carlosmsx/MSX-SDF-1/hardware/rev1/sdf1-sch.pdf

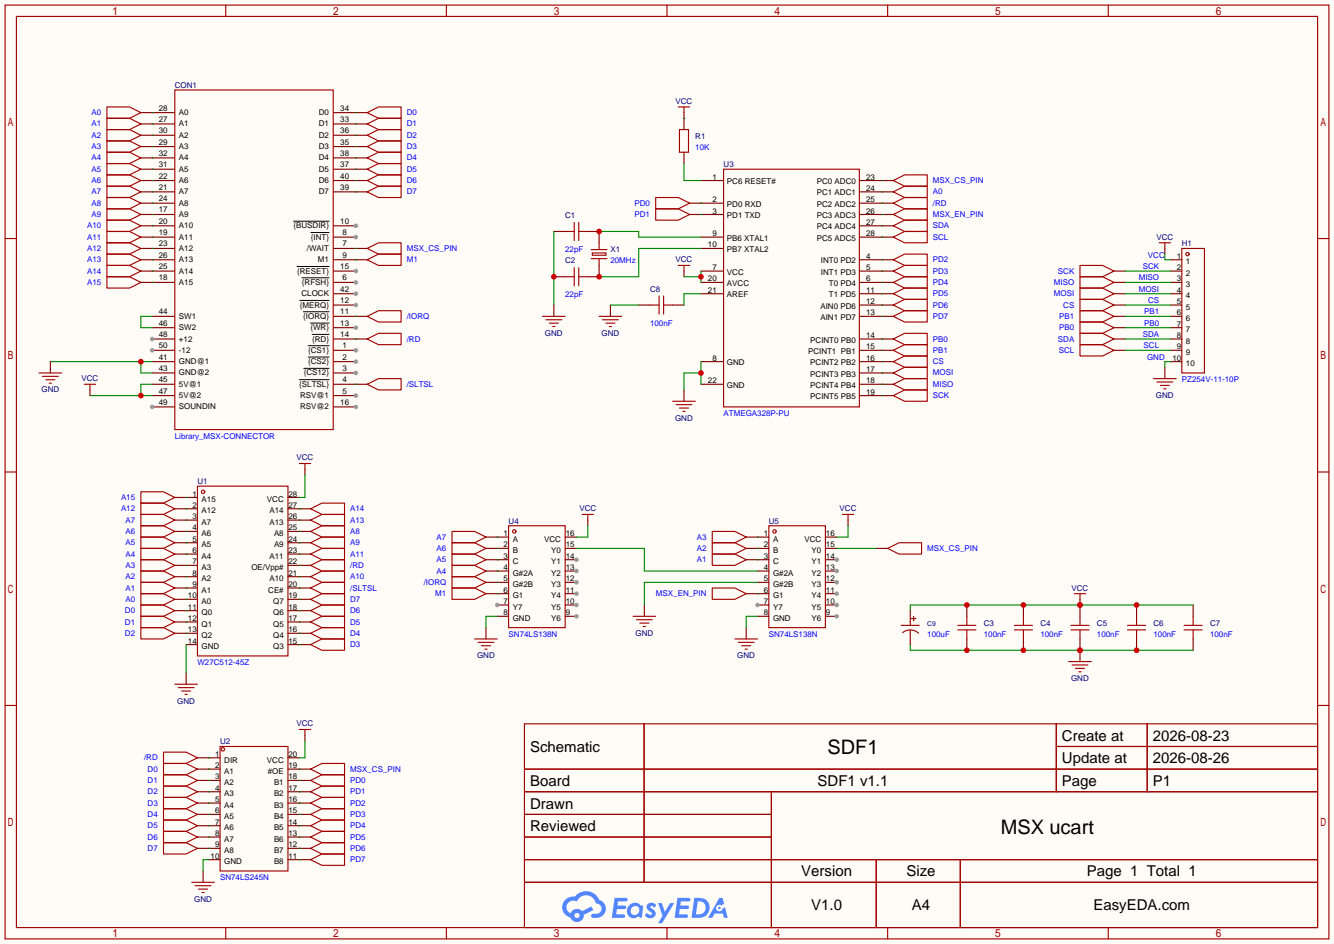
[picture p1: page 1]

Schematic | SDF1 | Create at | 2026-08-23

Update at | 2026-08-26

Board | SDF1 v1.1 | Page | P1
Drawn | | MSX ucart
Reviewed

Version | Size | Page 1 Total 1
V1.0 | A4 | EasyEDA.com
