carlosmsx/MSX-SDF-1/(commit log)

2023-04-13 Update README.md
    Agregando un poco mas de descripcion sobre el proyecto
2023-04-13 agregado codigo fuente para el atmega328p
2026-08-29 primer prototipo de PCB
    [sdf1-bom.csv]
2026-09-02 README: presentar la placa como kit de desarrollo
    El SDF-1 pasa a describirse como un kit de desarrollo para MSX -- una placa
    de I/O universal y experimental -- y el lector de memorias SD como su primer
    proyecto de ejemplo, que es lo unico terminado hoy.
    - Nueva seccion "La placa como kit": el hardware no es especifico de leer
    disquetes, el area de islas perforadas es parte del diseno, y el pinout de
    H1 (sin serigrafiar en la rev1) para colgar hardware propio del I2C/SPI
    - Advertencia explicita de que puerto serie, sensores y puente WiFi son
    intencion de diseno y todavia no existen como firmware ni ROM
2026-09-03 README: acreditar el Virtual MSX Disk Drive como antecedente
    El proyecto parte de la idea que Raul publico en codinglab en 2013:
    decodificar un puerto de I/O, bajar el /WAIT del Z80 con esa misma
    senal, y contestar con un microcontrolador mientras la maquina espera.
    La seccion nueva da el credito y detalla los siete puntos en los que
    este diseno se aparta del original: lee la SD sin PC de por medio,
    decodifica A7..A1 en vez de una ventana de puertos, separa datos de
    comando/estado en dos registros, documenta las cuatro lineas de
    control que van al micro, maneja el /WAIT con una compuerta de
    colector abierto, corre el ATmega a 20 MHz, y publica el codigo.
2026-09-03 README: bajar el peso del antecedente, subir el de las mejoras
    La seccion daba dos parrafos al proyecto original y cerraba diciendo
    que sin el no existiria. La idea es al reves: mencionar de donde sale
    la tecnica del /WAIT y que el foco quede en como esta resuelto todo lo
    demas. El credito pasa a una oracion con el link inline, y la seccion
    se llama ahora "Las decisiones de diseño".
2026-09-12 firmware y DiskROM: comandos CALL SDF y montaje de DSK desde la SD
    CALL SDFFILES lista los .DSK de la raiz, CALL SDFMOUNT(drive,"archivo") monta una imagen en A o B y CALL SDFUMOUNT(drive) la desmonta. El montaje se guarda en la EEPROM y ya no hay DSK fijos por defecto. CALL SDFTEST muestra la version del firmware y compara el protocolo con la ROM.
    DSKCHG consulta al firmware (portado de ZiggyBox, con flag por drive y DPB actualizado) y READ/WRITE leen un byte de estado antes de los sectores: un drive vacio devuelve not ready en vez de basura. Los codigos de comando quedan agrupados por funcion (0xDx diagnostico, 0xEx SD, 0xFx driver). Se corrige CHKCHAR, que caia en TYPE_MISMATCH. Protocol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
    [defs.h, sdf-1-atmega328p.ino]
2026-09-12 Makefile: make flash graba el .hex directo con avrdude
    arduino-cli upload con programador busca el .with_bootloader.hex, que MiniCore borra con bootloader=no_bootloader, asi que make flash fallaba siempre. Ahora llama a avrdude con el .ino.hex, elige -p m328p o m328 segun la variante del FQBN, y make check verifica avrdude y su avrdude.conf.
2026-09-12 hardware/rev1: correcciones en vez de bodges, mapas de cortes y de senales
    BODGES.md pasa a CORRECCIONES.md, sin la firma AB ni el cristal (el error del BOM queda en el README de rev1 y va a la rev2). /WAIT sale por dos compuertas de U6 (74LS03); /BUSDIR queda para mas adelante y /RESET del MSX a PB0 queda a probar.
    cortes-rev1.svg ubica los dos cortes y los puntos de soldadura sobre las pistas reales, sacadas de los Gerbers. senales-rev1.svg muestra que senal del bus del MSX llega a cada pad, para usar la placa sin los integrados.
2026-09-12 firmware: publicar el .hex con los comandos CALL SDF (version 0.1, protocolo 1)
    Compilado desde el codigo de este branch; verificado byte a byte contra una recompilacion y contra lo grabado en el ATmega328P. Va con una DiskROM compilada desde el mismo codigo: el protocolo cambio.
2026-09-12 tools: scripts de los mapas del PCB, make mapas y make icsp
    placa.py lee los derivados de una revision (Gerbers, FlyingProbeTesting.json, drills y netlist) y arma el grafo del cobre. mapa_cortes.py dibuja cortes-rev1.svg y con --analizar repite el estudio que eligio los cortes; mapa_senales.py dibuja senales-rev1.svg. make mapas los regenera.
    make icsp comprueba la conexion ICSP con el ATmega sin escribir nada: lee firma, fuses y lock, y con ICSP_EXTRA puede verificar la flash.
2026-09-12 hardware/rev1: mapas regenerados con los dos agujeros de fijacion del conector
    Los dos agujeros de fijacion del conector de cartucho se llaman igual en el archivo de test (CON1_999) y los scripts originales guardaban uno solo. En senales-rev1.svg ademas salia como un contacto cuadrado; ahora son dos circulos. El resto de los dos SVG no cambia.
2026-09-12 Makefile: anda desde PowerShell y cmd, sin sh
    Sin sh en el PATH, make corre las recetas con cmd.exe y fallaba: las carpetas del Arduino IDE se calculaban con $(shell cygpath) y quedaban vacias, asi que make icsp y make flash armaban el comando de avrdude sin ruta.
    Ahora las carpetas salen de USERPROFILE y LOCALAPPDATA leidas por make, arduino-cli recibe sus variables con export, los chequeos de make check usan wildcard/error/info, crear y borrar out/ va con python, y la receta de LK80 queda en una sola linea. Probado desde PowerShell y Git Bash: check, clean, rom, firmware, icsp y flash.
2026-09-12 hardware/rev1: U6 usa las compuertas 3 y 4 del 74LS03
    La 4 (12, 13 -> 11) hace de inversor y la 3 (9, 10 -> 8) de /WAIT: quedan todas del mismo lado del integrado, junto al pin 14 de VCC, y el puente del 11 al 10 es entre pines vecinos. Las compuertas 1 y 2 quedan libres para /BUSDIR. Actualizados la tabla, el pull-up, el checklist y la leyenda de cortes-rev1.svg.
2026-09-14 README: el kit lleva una EEPROM de 64 K regrabable, no una ROM de 16 K
    Los 16 K son de la DiskROM del lector de SD; la W27C512 se ve completa en el slot y se regraba con un adaptador.
2026-09-14 diskrom y firmware: imagenes DSK de 360 KB
    GETDPB elige el DPB por el primer byte de la FAT: F8 es un 360 KB de una
    cara, cualquier otro valor sigue siendo 720 KB. El kernel de DOS1 lee la FAT
    despues de un DSKCHG con cambio y llama a GETDPB con ese byte, asi que la ROM
    solo agrega la tabla y la eleccion. DEFDPB queda en el de 720 KB.
    El firmware acepta imagenes de 368640 bytes ademas de las de 737280, sin
    mirar el byte de la FAT: las imagenes de juegos sin FAT siguen montando. Una
    escritura con el DPB de 720 KB sobre una imagen que no es de 720 se rechaza
    con write fault, para que una ROM vieja no corrompa un 360 KB.
    Protocolo 2: la ROM y el firmware se graban juntos.
2026-09-15 firmware: arranca sin SD y SDFTEST muestra el estado de la SD
    setup() ya no espera a que la SD ande: la inicializa loop(), reintentando
    cada 250 ms, y mientras tanto la ISR atiende al MSX. Los comandos que
    necesitan la SD contestan que no esta (Disk offline, not ready, lista vacia)
    y CALL SDFTEST muestra por que: ok, iniciando, no contesta, no es FAT o el
    codigo de error de SdFat. Version 0.2.
    Makefile: los datos de BASDATA vuelven a F327h. El .REL de N80 le hacia
    reservar a LK80 un byte de datos de mas y corria las variables de sistema de
    MSX-DOS; con --data F327h antes de BASDATA el link reproduce la ROM de
    ZiggyBox byte a byte. Las rutas de out/ en python van como cadenas crudas.
    [defs.h, sdf-1-atmega328p.ino]
2026-09-15 diskrom y firmware: pagina 2 con CALL SDFNEW y formateo de imagenes
    La EEPROM usa la pagina 2 (8000h) para las rutinas de manejo, en
    diskrom/PAGE2.MAC: un binario absoluto aparte, sin codigo del kit de ASCII,
    que mkrom.py agrega a la imagen. La pagina 1 solo lee argumentos de BASIC y
    salta con CALLP2 (GETSLOT y ENASLT, y RAMAD2 al volver). SDFMOUNT y
    SDFUMOUNT quedan en la pagina 1; SDFFILES y SDFTEST se mudaron enteros. Los
    codigos de comando pasan a diskrom/PROTOCOL.INC, y sale codigo muerto de la
    pagina 1: le quedan 2057 bytes libres.
    CALL SDFNEW("archivo"[,360|720]) crea una imagen formateada y llena de
    ceros, sin montarla. CALL FORMAT y el FORMAT de MSX-DOS formatean la imagen
    montada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
2026-09-21 tools/mkrom.py: escribe la entrada DEVICE de la cabecera
    DOSHEAD trae 4006h en 0 y el BIOS arma SLTATR al arrancar, asi que el
    cartucho no puede prenderse el bit de DEVICE desde su INIT: tiene que venir
    en la imagen. LK80 deja la lista de simbolos en out/msxdos.sym y mkrom.py
    escribe ahi la direccion de OEMDEV, si existe. Falla si el simbolo cae fuera
    de la pagina 1 o si 4006h no venia en 0.
2026-09-21 diskrom y firmware: dispositivos de BASIC, RTC: sobre un DS1307 y CALL SDFDEBUG
    La ROM gana OEMDEV, un tubo generico sin tabla de nombres: le pregunta al
    firmware si un nombre es suyo (comandos 0x9x) y despues mueve bytes. Un
    dispositivo nuevo es firmware, no ROM. El despachador preserva DE: el OPEN
    lee el modo en E y el codigo en D.
    El primer dispositivo es RTC:, sobre un DS1307 por I2C. LINE INPUT trae la
    hora de ese momento, con formatos RTC:, RTC:D, RTC:T, RTC:N y RTC:W; PRINT #
    pone el reloj y EOF avisa si la hora no es confiable. El I2C va con el TWI
    en crudo, sin Wire (182 bytes de RAM menos), y nunca desde la ISR: loop()
    relee el chip a una copia doble y la ISR arma la linea desde a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
2026-09-21 pruebas: sketches de prueba de perifericos con un Nano
    Enlace I2C con un ESP32 (maestro Nano, esclavo ESP32) y un MAX7219.
2026-09-22 Makefile y parche para DS1307: redirigir B4h/B5h a puertos del firmware
    Agrega 'make rom-rtc' que compila la DiskROM y parchea los 27 accesos
    a los puertos RP-5C01 (B4h/B5h) para redirigirlos a los puertos 0/1
    del firmware, donde se emula el RP-5C01 completo usando un DS1307 por I2C.
    Cambios:
    - Makefile: nueva regla 'rom-rtc' que aplica el parche automáticamente
    - tools/patch_rtc.py: parche que reemplaza inmediatos de puerto
    * OUT (0B4h),A → OUT (0x01),A (comando)
    * OUT (0B5h),A → OUT (0x00),A (datos escritura)
    * IN A,(0B5h) → IN A,(0x00) (datos lectura)
    Verificado: los 27 accesos encontrados y parcheados en el rango 0x40BA-0x41BA.
    El espacio en ROM no cambia (solo r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
2026-09-22 Firmware: emulación del RP-5C01 en puertos 0/1 usando DS1307
    Implementa la emulación completa del RP-5C01 (reloj de MSX2) usando el DS1307
    por I2C. La DiskROM accede a los puertos redirigidos (0x00/0x01) que el firmware
    atiende, pensando que está hablando con un RP-5C01 real.
    Cambios en el firmware:
    - Shadow de 52 bytes para los 4 bancos (0=reloj, 1=alarma, 2/3=RAM CMOS)
    - Manejador de comandos 0x0X: latchea el registro seleccionado
    - Lectura de nibbles: devuelve 0F0h | nibble como el chip real
    - Escritura de nibbles: actualiza el shadow, marca para escribir al DS1307
    - rtcUpdateShadow(): convierte DS1307 (BCD 8-bit) al formato RP-5C01 (nibbles)
    - Llamado desde loop() cada 25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
2026-09-22 Tools: verificación de parche DS1307 en ROM
    Agrega dos scripts para verificar que la ROM grabada tiene el parche DS1307:
    1. verify_rtc.py: verifica que el parche esté correctamente aplicado
    - Busca los 27 patrones parchados (D301, D300, DB00)
    - Verifica que NO haya patrones antiguos (D3B4, D3B5, DBB5)
    - Cuenta y reporta coincidencias esperadas
    - Salida clara: ✓ ROM VERIFICADA o ✗ ROM NO VERIFICADA
    2. fingerprint_rtc.py: genera un fingerprint para guardar junto a la ROM
    - Extrae bytes clave de 6 ubicaciones (primero y último de cada patrón)
    - Calcula SHA256 y MD5 de esos bytes
    - Genera archivo .fingerprint con la información
    - Útil para comparar luego si es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
2026-09-22 Firmware: corrige la decodificacion de banco/registro del RP-5C01 emulado
    Bug encontrado al probar en hardware: el MSX seguia pidiendo fecha al
    arrancar pese a que la ROM tenia el parche aplicado. La emulacion del
    RP-5C01 tenia dos errores de diseño:
    1. Decodificacion de banco/registro incorrecta. El indice de registro
    (0-Fh) que llega por el puerto de comando NO codifica el banco: el
    banco activo lo fija el VALOR que se escribe en el registro de modo
    (indice 0Dh), en sus bits 0-1. El codigo anterior extraia "banco" y
    "registro" de los bits del indice mismo, que es un modelo distinto
    e incorrecto del chip. Con eso, cuando CHKCLK seleccionaba banco 2
    (RAM CMOS) para la pru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
    [sdf-1-atmega328p.ino]
2026-09-22 Reloj: camino A - parchear CHKCLK/$GETTI/$SETDA/$SETTI en vez de emular el RP-5C01
    El camino B (emular el RP-5C01 completo en los puertos B4h/B5h, commits
    5570ffa/12786b7/6f55042) se probo en hardware y sigue pidiendo fecha al
    arrancar. Diagnostico: no es un bug de logica sino un limite de timing.
    El bucle de deteccion de CHKCLK hace un OUT seguido de un IN con solo 8
    T-states de separacion (~2,2us a 3,58MHz) - el acceso mas apretado de toda
    la ROM, ya señalado como riesgo en reloj-cuatro-caminos.md. El firmware
    tarda 6us (MSX_REENABLE_DELAY_US, documentado y deliberado en defs.h) en
    rehabilitar el decoder entre accesos, asi que ese segundo acceso cae dentro
    de la "cuarentena": el decoder n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
    [defs.h, sdf-1-atmega328p.ino]
2026-09-23 firmware: publicar el .hex 0.2 (protocolo 6)
    Compilado con make -B firmware desde ea9960c: 22656 bytes de flash (69 %),
    710 de RAM libres. Suma el reloj DS1307 (OPEN "RTC:", CALL RTC y el camino A
    para MSX-DOS), CALL SDFNEW, imagenes de 360 KB y CALL SDFDEBUG.
    El README aclara que va con una ROM del mismo commit y que la fecha en
    MSX-DOS pide make rom-rtc.
2026-09-23 README: el reloj DS1307 como segundo proyecto de ejemplo
    El README decia que el lector de SD era lo unico terminado. Ahora nombra
    el reloj, con links a las paginas de los dos ejemplos en dpc200.com.ar.
2026-09-24 README: tono mas formal, y el proyecto de Raul como inspiracion
    El texto pasa a un registro formal e impersonal, sin voseo ni
    expresiones coloquiales. El contenido tecnico no cambia.
    La seccion de decisiones de diseño ya no compara punto por punto con
    el Virtual MSX Disk Drive: dice que el proyecto esta inspirado en el,
    del que toma la tecnica del /WAIT, y describe los agregados y mejoras
    por si mismos.
2026-09-24 Firmware: /WAIT diferido, y el SD.open de DSKIO pasa a loop()
    Primer paso para sacar la SD de la ISR. Cuando un acceso necesita la SD,
    la ISR vuelve sin soltar /WAIT y deja el pedido en _deferred; loop() hace
    el trabajo con las interrupciones habilitadas, pone el byte en el bus y
    suelta /WAIT (serviceDeferred/replyDeferred). El MSX ve lo mismo que antes:
    la ROM y el protocolo no cambian.
    El primer uso es abrir la imagen de DSKIO: el SD.open() y el seek() salen
    de processData() y los hace loop() cuando el MSX lee el byte de estado.
    Los rechazos que no necesitan la SD (sin tarjeta, drive sin imagen) siguen
    contestandose desde la ISR, sin diferir.
    El EEPROM.update de loop() atiende pedidos en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
2026-09-24 Pruebas: SDFBENCH.BAS, velocidad del disco desde Disk BASIC
    Escritura y lectura de 16 KB x 8 con BSAVE/BLOAD, verificacion contra la
    BIOS y 64 GET al azar. Cada corrida se agrega a RESULT.TXT con una
    etiqueta, para comparar versiones sobre la misma imagen. Los .BAS se fijan
    en CRLF, que es lo que espera el LOAD del MSX.
2026-09-24 SDFBENCH: medir con RTC: en lugar de TIME
    TIME no cuenta mientras se accede al disco (interrupciones cortadas): la
    primera corrida dio 156 KB/s de lectura, mas de tres veces el maximo
    posible. Cada prueba arranca en un cambio de segundo del reloj y al final
    descuenta, con TIME, la espera hasta el segundo siguiente, que no toca el
    disco. Pruebas mas largas (N=32, M=256) para que el error de +-0,25 s del
    reloj quede en ~1 %. Sin reloj vuelve a TIME y lo marca en RESULT.TXT.
2026-09-25 SDFBENCH: reponer HIMEM al terminar
    El CLEAR 300,&H9800 deja la pila en la pagina 2, y CALLP2 cambia esa
    pagina a la ROM: CALL SDFTEST, SDFFILES, SDFNEW y el formateo se cuelgan
    hasta resetear. El HIMEM original se guarda en D81E-D81F antes del CLEAR
    y se repone en todas las salidas.
2026-09-26 SDFBENCH: dia de semana como texto, y reponer HIMEM tambien tras un error
    INPUT # del ultimo campo de RTC:N da Type mismatch con una variable
    numerica; con W$ anda. El manejador de errores hacia ON ERROR GOTO 0, que
    corta el programa en el acto y salteaba la linea 950: ahora sale con
    RESUME 950, que repone HIMEM.
2026-09-26 Firmware: version desde git, y fecha y hora de compilacion en SDFDEBUG
    make firmware pasa FW_GIT con git describe: CALL SDFTEST muestra
    "0.2-8-abc1234" (tag, commits desde el tag, commit) y un * si se compilo
    con cambios sin commitear. Desde el IDE, sin git, queda la version a mano
    con la fecha, como antes. El firmware se compila siempre (FORCE), porque
    la version cambia con cada commit aunque las fuentes no.
    Al arrancar deja en el buffer de CALL SDFDEBUG la version con la fecha y
    hora exactas de compilacion. El texto va en la flash (dbgP/PSTR): la RAM
    baja de 1338 a 1318 bytes.
2026-09-26 Firmware: estadisticas del disco en CALL SDFDEBUG
    Para medir antes de optimizar. Con DSK_STATS, el firmware cuenta las
    llamadas a DSKIO y los sectores, y mide con Timer1 (3,2 us por tick) el
    tiempo de abrir la imagen, de dsk.read() (separando las lecturas que traen
    un bloque de la SD), dsk.write(), flush() y close(). CALL SDFDEBUG agrega
    el informe al buffer y pone todo en cero; lo arma loop() por /WAIT
    diferido, porque son divisiones de 32 bits.
    Cuesta ~35 ciclos por byte en la ISR, 84 bytes de RAM (buffer de
    SDFDEBUG a 128) y 1,6 KB de flash; DSK_STATS 0 lo saca del todo.
    SDFBENCH llama a CALL SDFDEBUG despues de cada prueba.
2026-09-26 Firmware: las imagenes de A y B quedan abiertas entre un DSKIO y otro
    Abrir la imagen buscaba el nombre en la raiz de la SD en cada llamada a
    DSKIO: ~19 ms, medido con las estadisticas de SDFDEBUG (29 % del tiempo de
    un GET al azar). Ahora dskioOpen() la abre la primera vez que hace falta y
    la deja abierta en _img[drive]; cada DSKIO solo hace el seek. Si la SD la
    tiene de solo lectura se abre igual para leer, y una escritura contesta
    not ready como antes.
    CALL SDFMOUNT y SDFUMOUNT, que corren en la ISR, solo marcan el drive en
    _img_stale: la imagen vieja la cierra loop() en el proximo DSKIO. NEW_DRIVE
    (CALL SDFNEW) sigue abriendose y cerrandose en cada llamada.
    Las estadisticas suman la ma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
2026-09-26 Firmware: transferencia directa entre la SD y el Z80 para imagenes contiguas
    dsk.read() de SdFat costaba ~25 us por byte aun con el sector en cache, y
    escribir de a byte obligaba a SdFat a leer y reescribir cada sector: ~18 ms
    por sector (medido con SDFDEBUG). Si la imagen de A o B ocupa sectores
    contiguos en la SD (contiguousRange() al abrirla), un DSKIO ya no pasa por
    SdFat:
    - Al contestar el estado de DSKIO, loop() hace SD.cacheClear() y arranca
    una lectura o escritura de varios bloques (readStart/writeStart: CMD18 y
    CMD25) en el sector absoluto de la SD.
    - Cada byte, la ISR lo pasa por SPI a mano (~65 ciclos contra ~500).
    - El primer y el ultimo byte de cada sector van diferidos a l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
2026-09-26 Firmware: escritura directa apagada (RAW_WRITE 0) y limitada a la imagen
    La lectura directa no puede daniar nada; la escritura directa si: un error
    escribiria sectores de la SD que no son de la imagen. Queda detras de
    RAW_WRITE en defs.h, apagada, para probarla con una SD sin nada que
    importe. Con RAW_WRITE 0 las escrituras van por SdFat como antes.
    Aun prendida, rawStart() exige que todo el pedido caiga entre el primer y
    el ultimo sector que dio contiguousRange() al abrir la imagen; si no, ese
    DSKIO va por SdFat. Es una red aparte del chequeo de fileSize().
    [defs.h, sdf-1-atmega328p.ino]
2026-09-26 Firmware: paso 4, nada de la ISR espera a la SD
    Lo que todavia tocaba la SD desde la ISR pasa a loop() por /WAIT diferido,
    con el mismo patron que el estado de DSKIO: la ISR junta los parametros y
    valida lo que no necesita la SD, y la lectura del resultado la contesta
    loop().
    - CALL SDFFILES: rebobinar la raiz y buscar cada .DSK (DEFER_FILES_NEXT).
    - CALL SDFMOUNT: abrir y verificar la imagen (mountDisk en la ISR,
    mountFinish en loop, DEFER_MOUNT).
    - DSKFMT: el largo de la imagen (formatRequest en la ISR, formatMedia en
    loop, DEFER_FORMAT).
    - DSKIO por SdFat (escrituras con RAW_WRITE 0, imagenes fragmentadas,
    NEW_DRIVE): el primer byte de cada sector trae el bloque y el ultimo hace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
2026-09-26 Firmware: version a mano 0.3, la que se ve compilando sin git
2026-09-26 firmware: publicar el .hex 0.3 (protocolo 6)
    Compilado con make firmware desde 41daec3 (el merge, con el tag v0.3):
    CALL SDFTEST muestra 0.3-0-41daec3. 26560 bytes de flash (81 %), 510 de RAM
    libres; pila libre minima medida 176. Misma ROM que la 0.2.
